memrecakal/Design-of-a-Multi-Purpose-Remote-Controlled-Underwater-Vehicle-Using-ROS-2-Unity-and-MATLAB-/ESP32/readme.md

* Tested on ESP32 Dev Module 240MHz 1 Core, 4MB model with MPU6050 DMP6 Libaray.
* Thanks Jeff Rowberg <jeff@rowberg.net> for his amazing work https://github.com/jrowberg/i2cdevlib.
* Pin and timer usage should be clear, but if not feel free to contact.
