memrecakal/Design-of-a-Multi-Purpose-Remote-Controlled-Underwater-Vehicle-Using-ROS-2-Unity-and-MATLAB-/Unity Simulation/Assets/Exterior_swimming_pool/Documentation/Readme.txt

Exterior Swimming Pool
v1.1

Thank you for supportting this asset!

This asset contain 9 prefabs and a scene for example.
I added my own colliders for the stair that you can remove if you want.
The materials are based on Seamless textures exept for the diving board.

You can easly remove or change the materials.

If you have any questions,issues please contact me at: izartax@hotmail.fr
