memrecakal/Design-of-a-Multi-Purpose-Remote-Controlled-Underwater-Vehicle-Using-ROS-2-Unity-and-MATLAB-/Unity Simulation/Assets/Exterior_swimming_pool/Textures/AO/esp_concrete_floor_ao.png

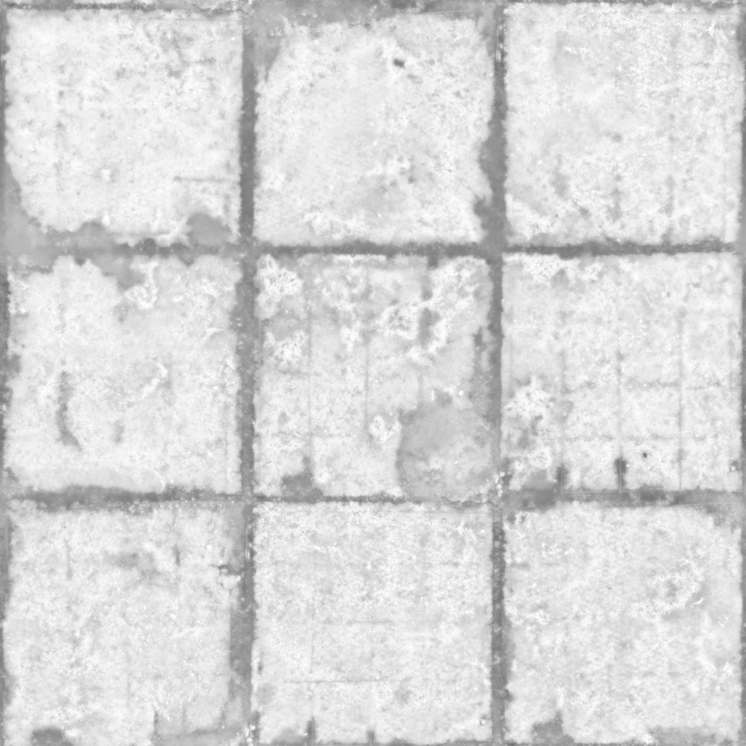
Unity Simulation/Assets/Exterior_swimming_pool/Textures/AO/esp_concrete_floor_ao.png
