memrecakal/Design-of-a-Multi-Purpose-Remote-Controlled-Underwater-Vehicle-Using-ROS-2-Unity-and-MATLAB-/Unity Simulation/Assets/Exterior_swimming_pool/Textures/AO/esp_stone_trim_r_ao.png

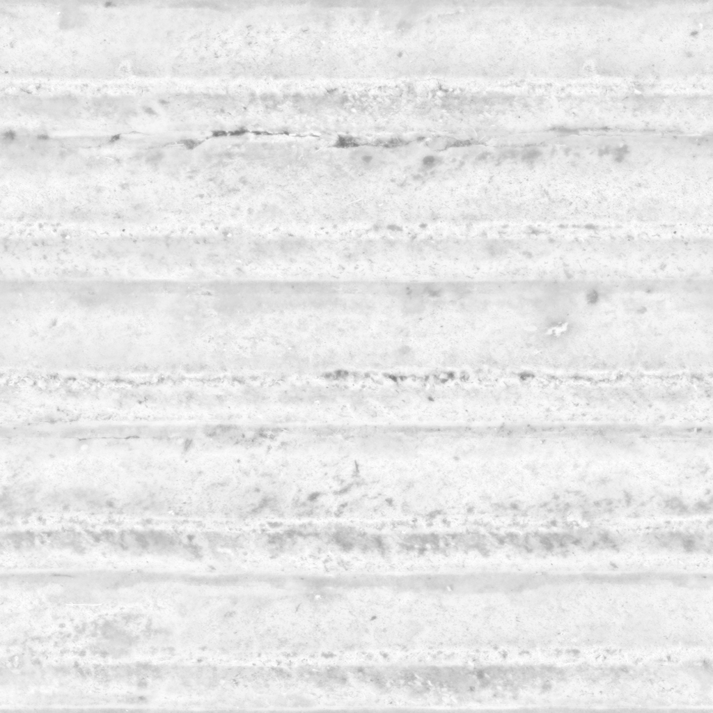
Unity Simulation/Assets/Exterior_swimming_pool/Textures/AO/esp_stone_trim_r_ao.png
