memrecakal/Design-of-a-Multi-Purpose-Remote-Controlled-Underwater-Vehicle-Using-ROS-2-Unity-and-MATLAB-/Unity Simulation/Assets/Exterior_swimming_pool/Textures/AO/esp_tile_color1_ao.png

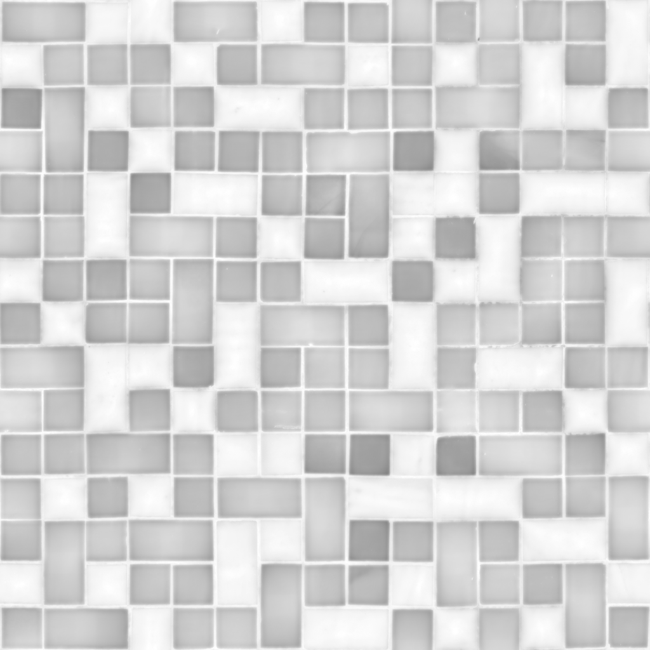
Unity Simulation/Assets/Exterior_swimming_pool/Textures/AO/esp_tile_color1_ao.png
