memrecakal/Design-of-a-Multi-Purpose-Remote-Controlled-Underwater-Vehicle-Using-ROS-2-Unity-and-MATLAB-/Unity Simulation/Assets/Exterior_swimming_pool/Textures/esp_concrete_floor.png

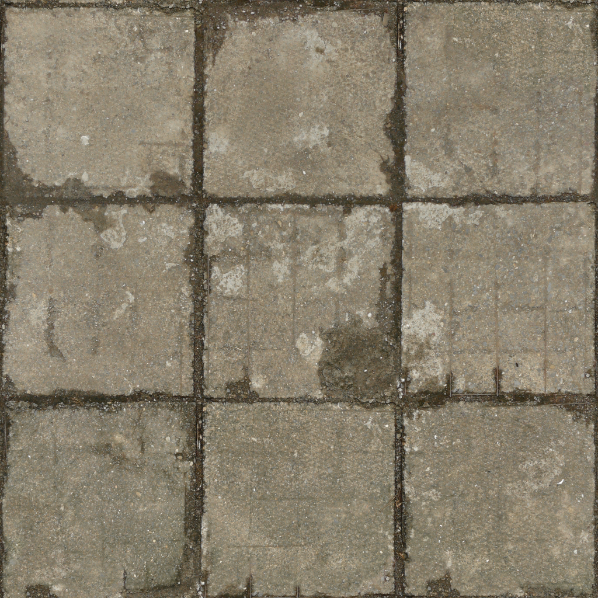
Unity Simulation/Assets/Exterior_swimming_pool/Textures/esp_concrete_floor.png
