memrecakal/Design-of-a-Multi-Purpose-Remote-Controlled-Underwater-Vehicle-Using-ROS-2-Unity-and-MATLAB-/Unity Simulation/Assets/Exterior_swimming_pool/Textures/NORMAL/esp_stone_trim_r_nml.png

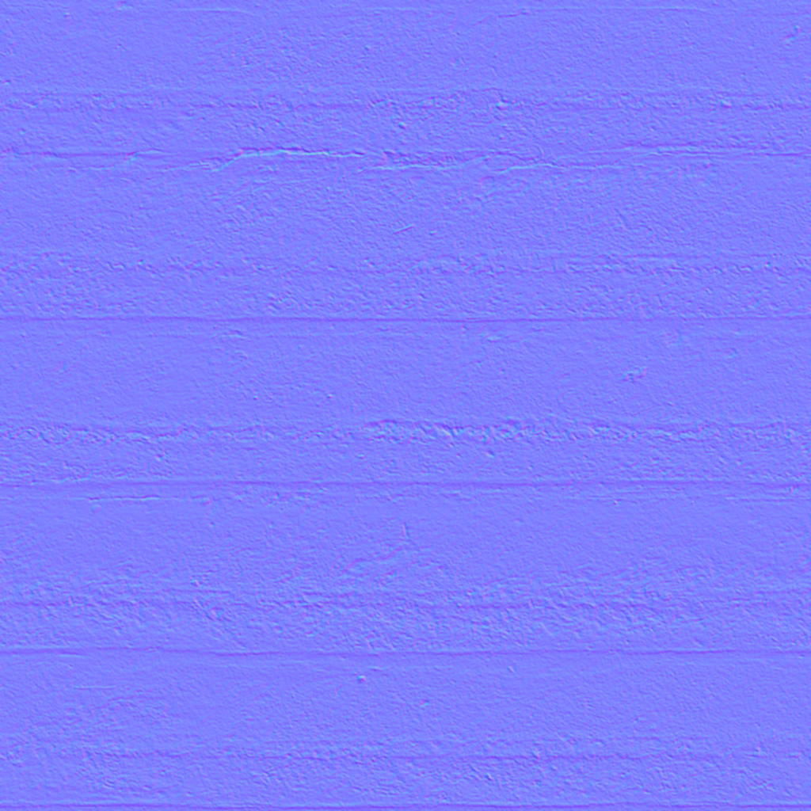
Unity Simulation/Assets/Exterior_swimming_pool/Textures/NORMAL/esp_stone_trim_r_nml.png
