memrecakal/Design-of-a-Multi-Purpose-Remote-Controlled-Underwater-Vehicle-Using-ROS-2-Unity-and-MATLAB-/Unity Android Controller App/Assets/stl/AnsysSolidPart.STL

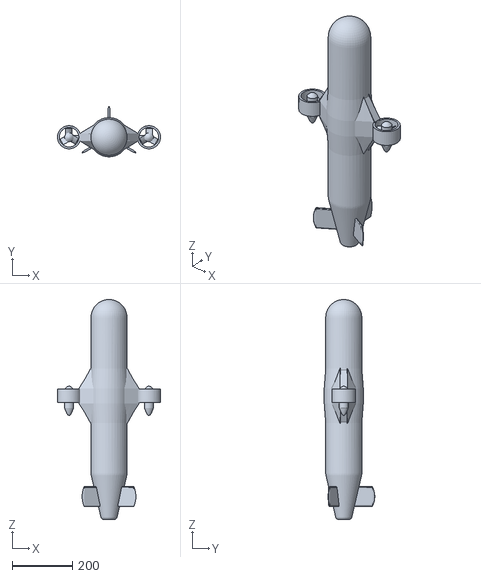
[picture p79: CAD file, 2023-11-21]
Unity Android Controller App/Assets/stl/AnsysSolidPart.STL
342.0 x 167.9 x 730.0
