memrecakal/Design-of-a-Multi-Purpose-Remote-Controlled-Underwater-Vehicle-Using-ROS-2-Unity-and-MATLAB-/(commit log)

2023-11-19 Update README.md update on comm frame
2023-11-19 Update README.md actuators and sensors
2023-11-21 Added ESP32 source code
2023-11-21 Added Raspberry Pi scripts
2023-11-21 Added the controller app
    [AnsysSolidPart.STL]
